dnepliuk/bluetooth-speaker-esp32/BluetoothSpeaker.kicad_pcb

## KiCad design BluetoothSpeaker.kicad_pcb (2026-11-05)

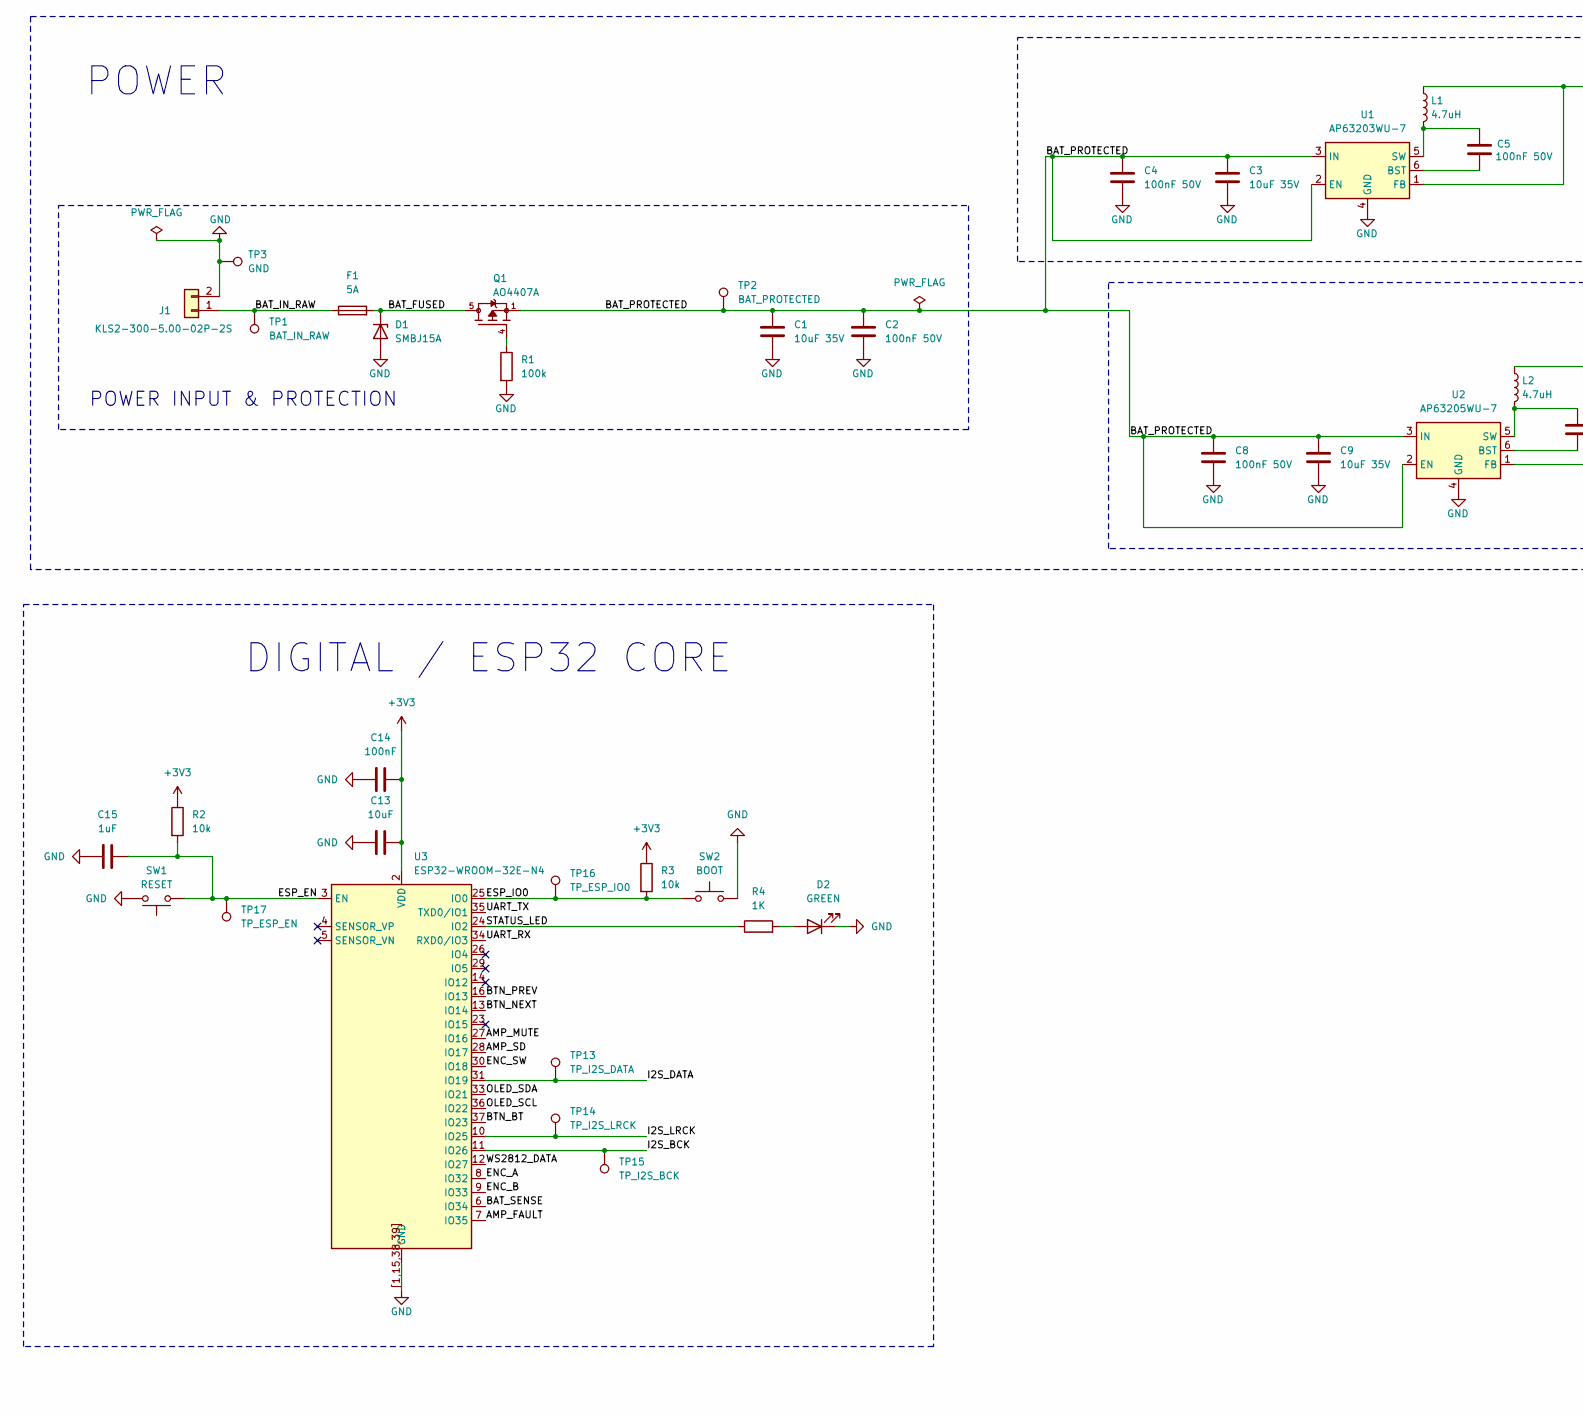
[picture p1: schematic BluetoothSpeaker.kicad_sch, part in row 1, column 1]

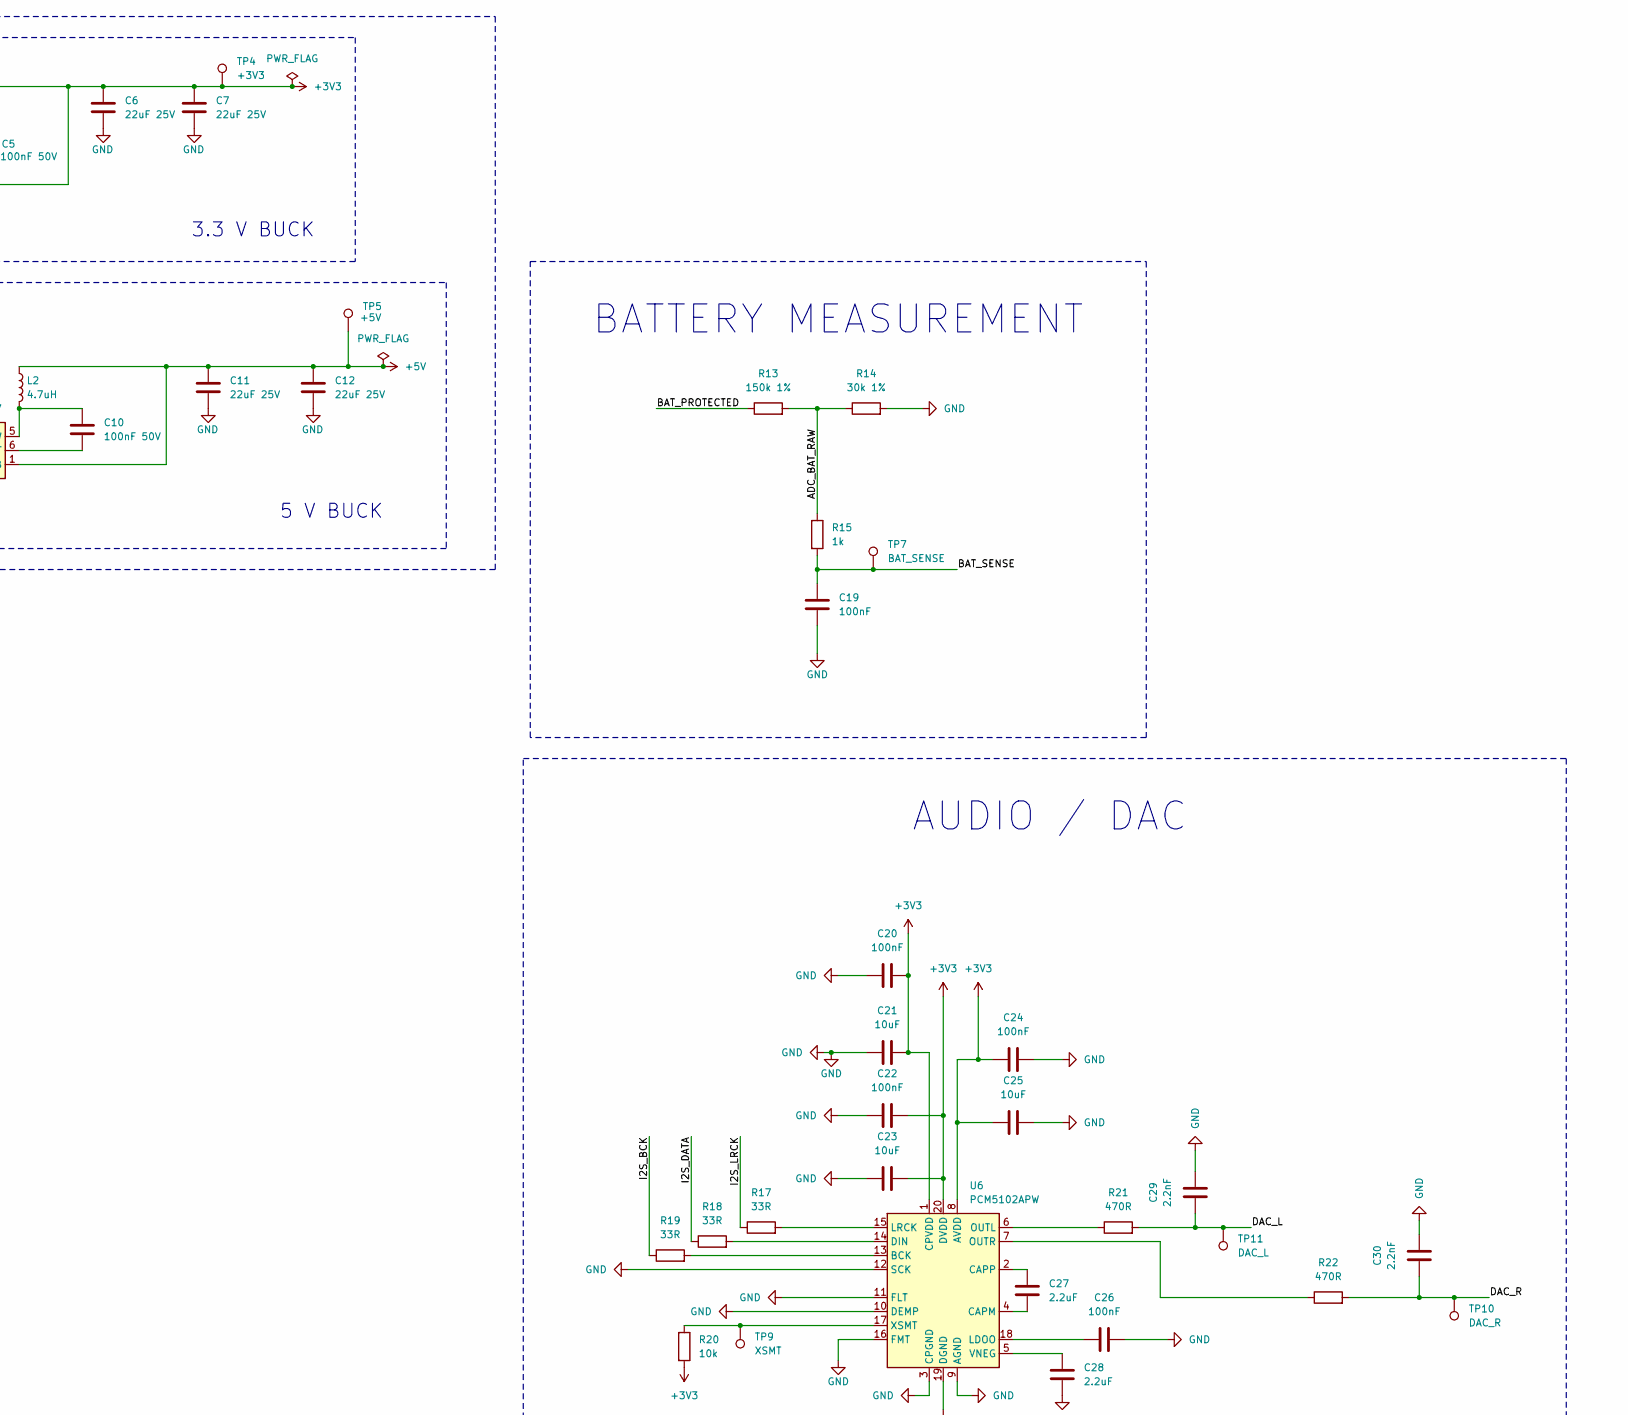
[picture p2: schematic BluetoothSpeaker.kicad_sch, part in row 1, column 2]

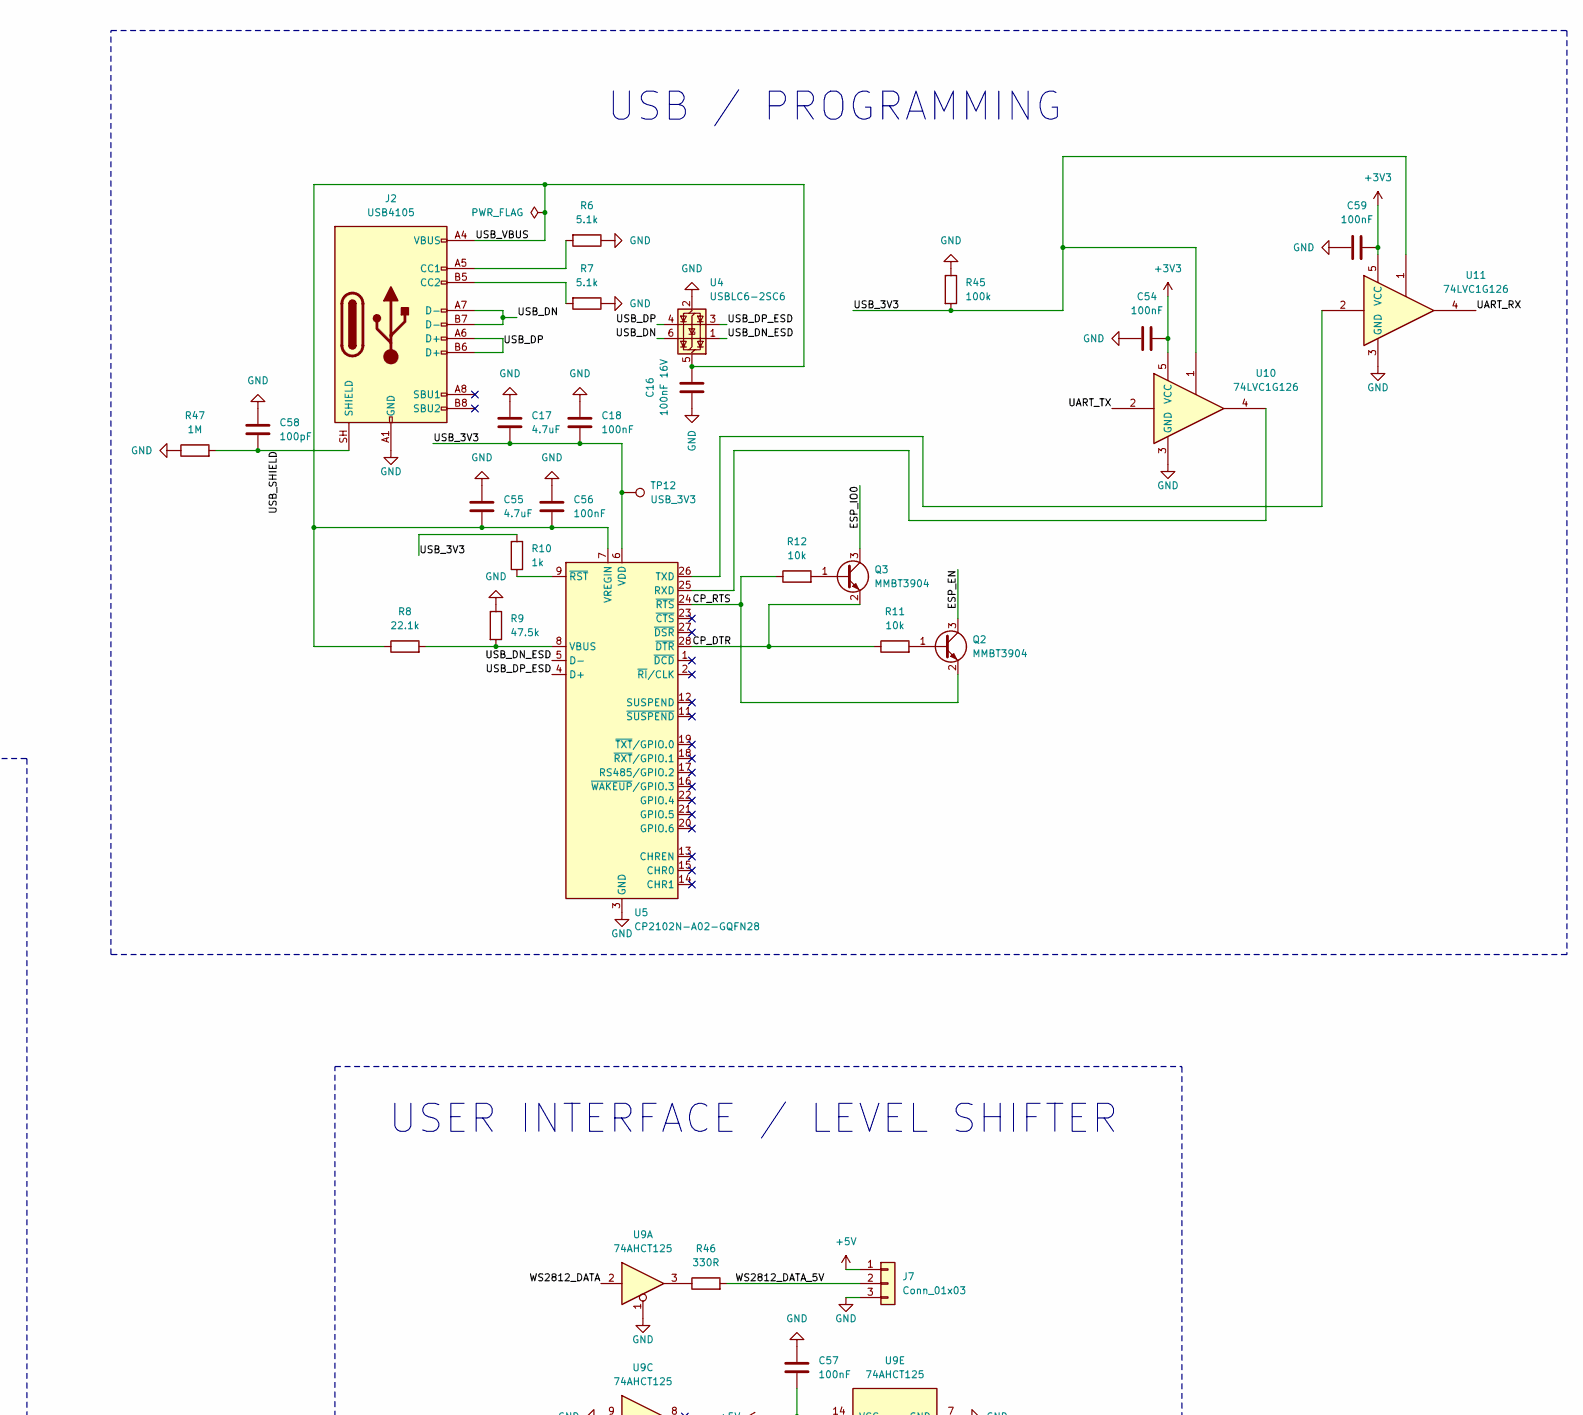
[picture p3: schematic BluetoothSpeaker.kicad_sch, part in row 1, column 3]

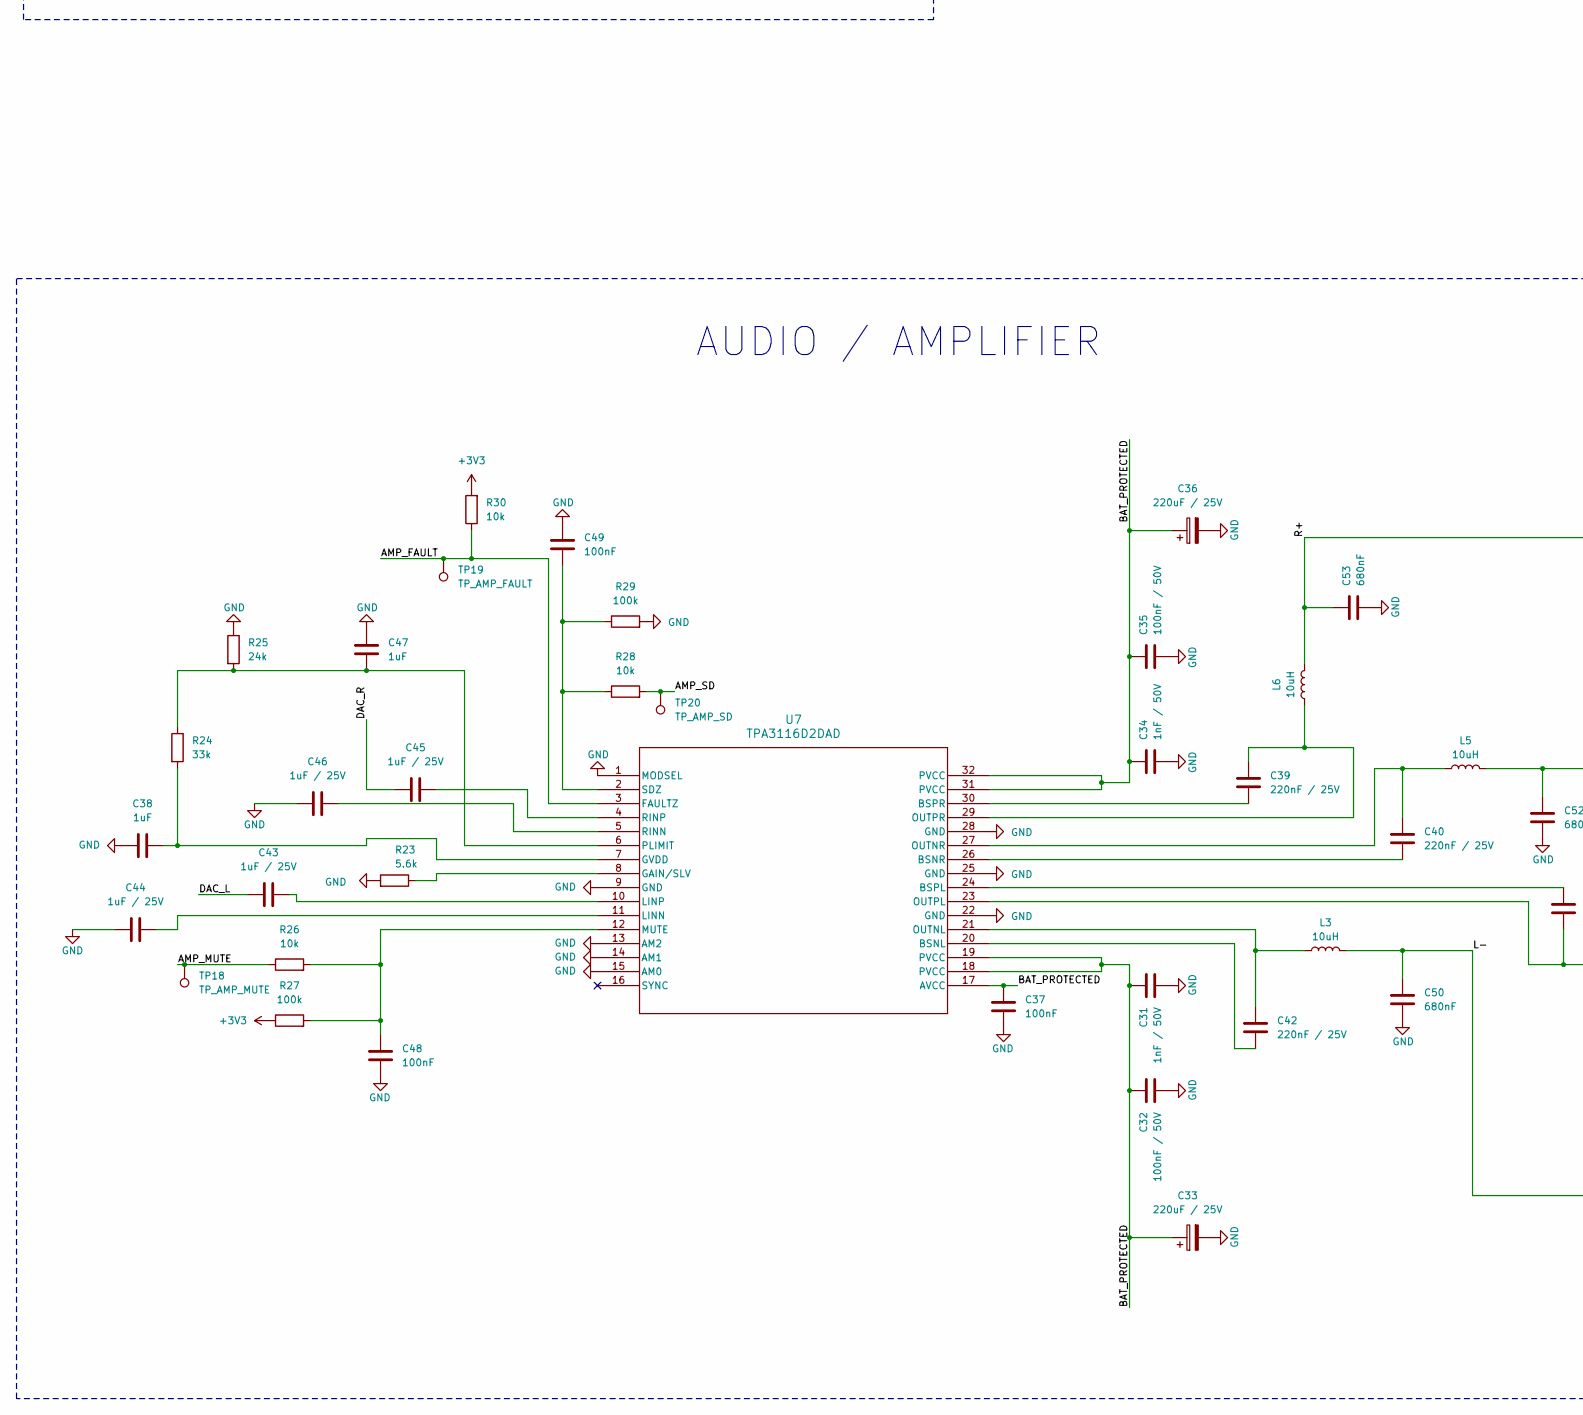
[picture p4: schematic BluetoothSpeaker.kicad_sch, part in row 2, column 1]

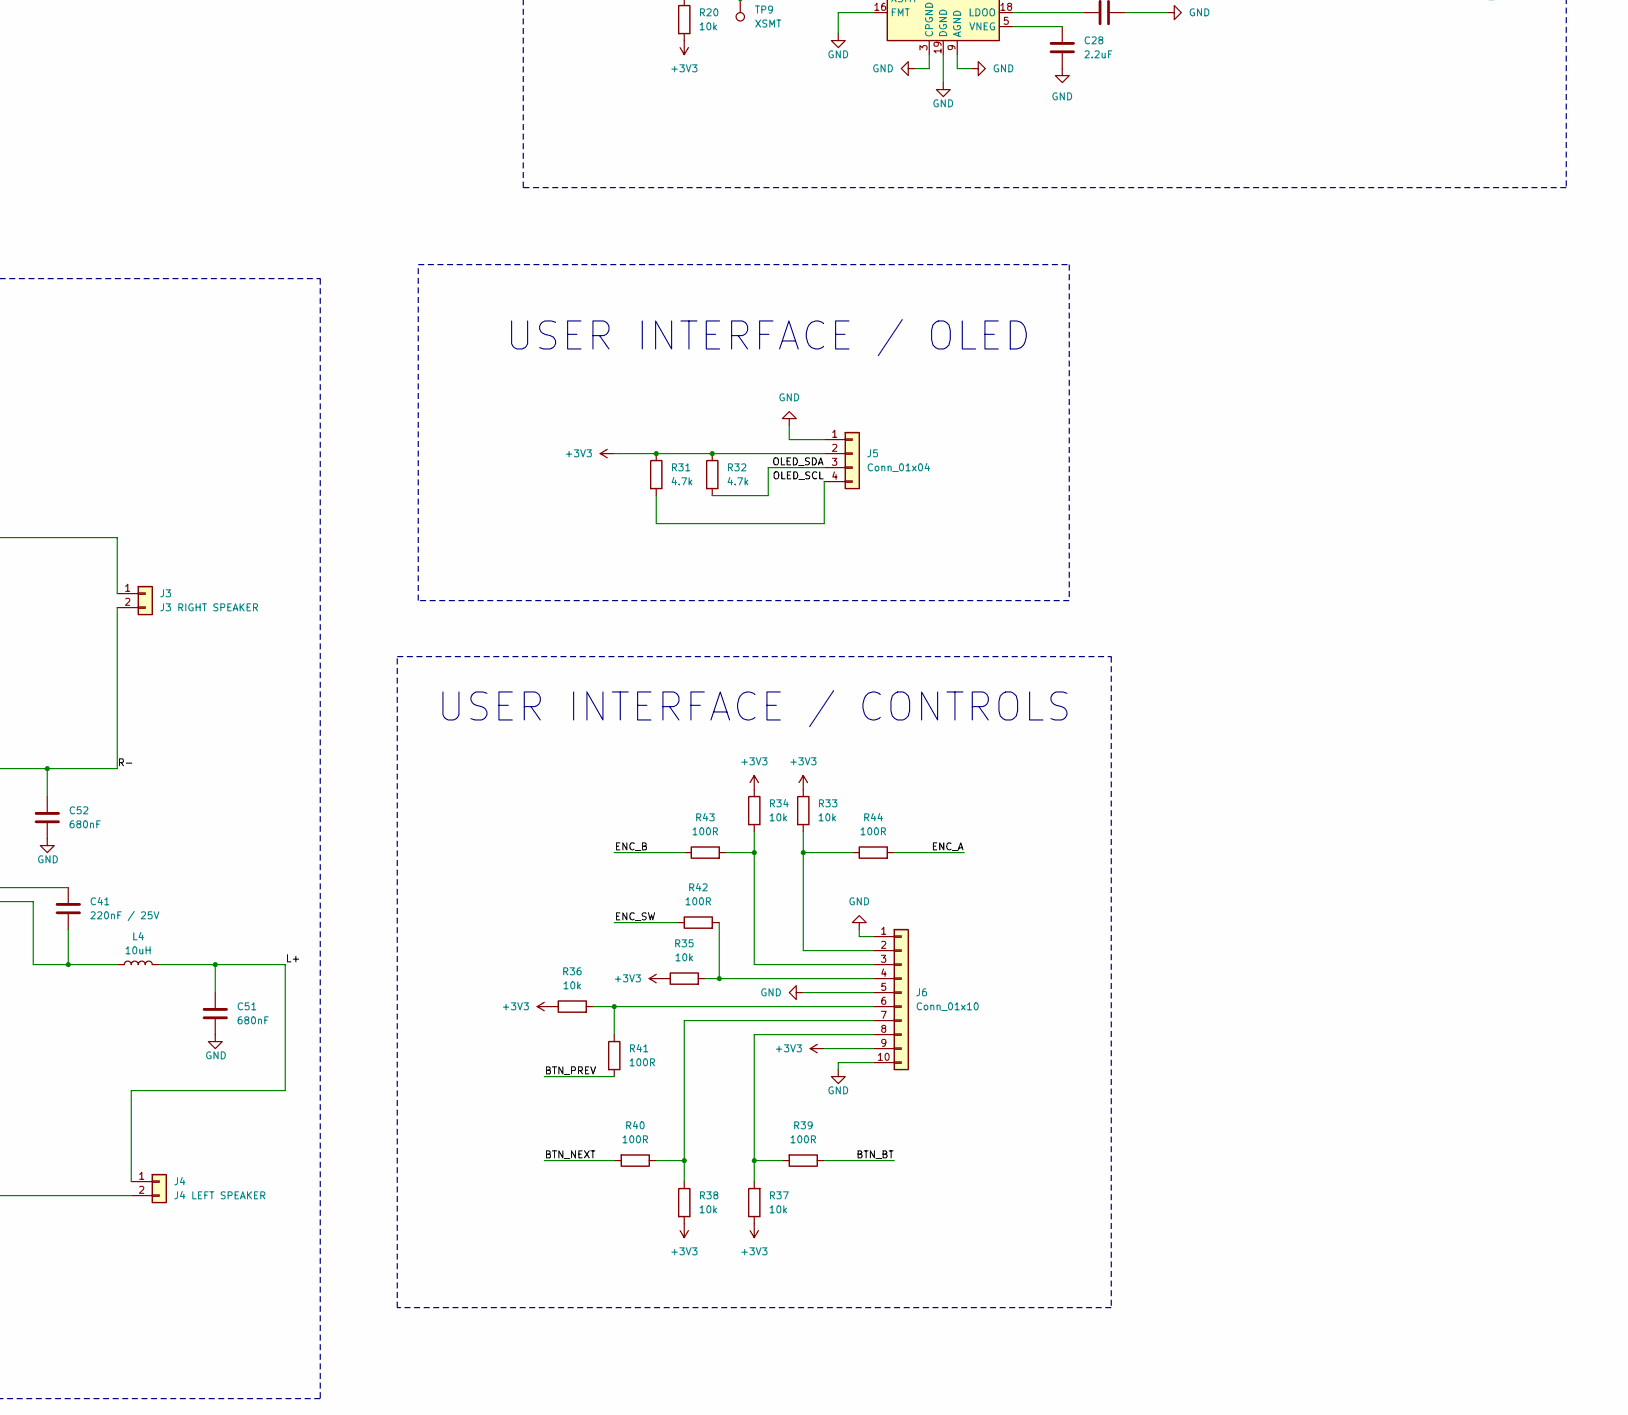
[picture p5: schematic BluetoothSpeaker.kicad_sch, part in row 2, column 2]

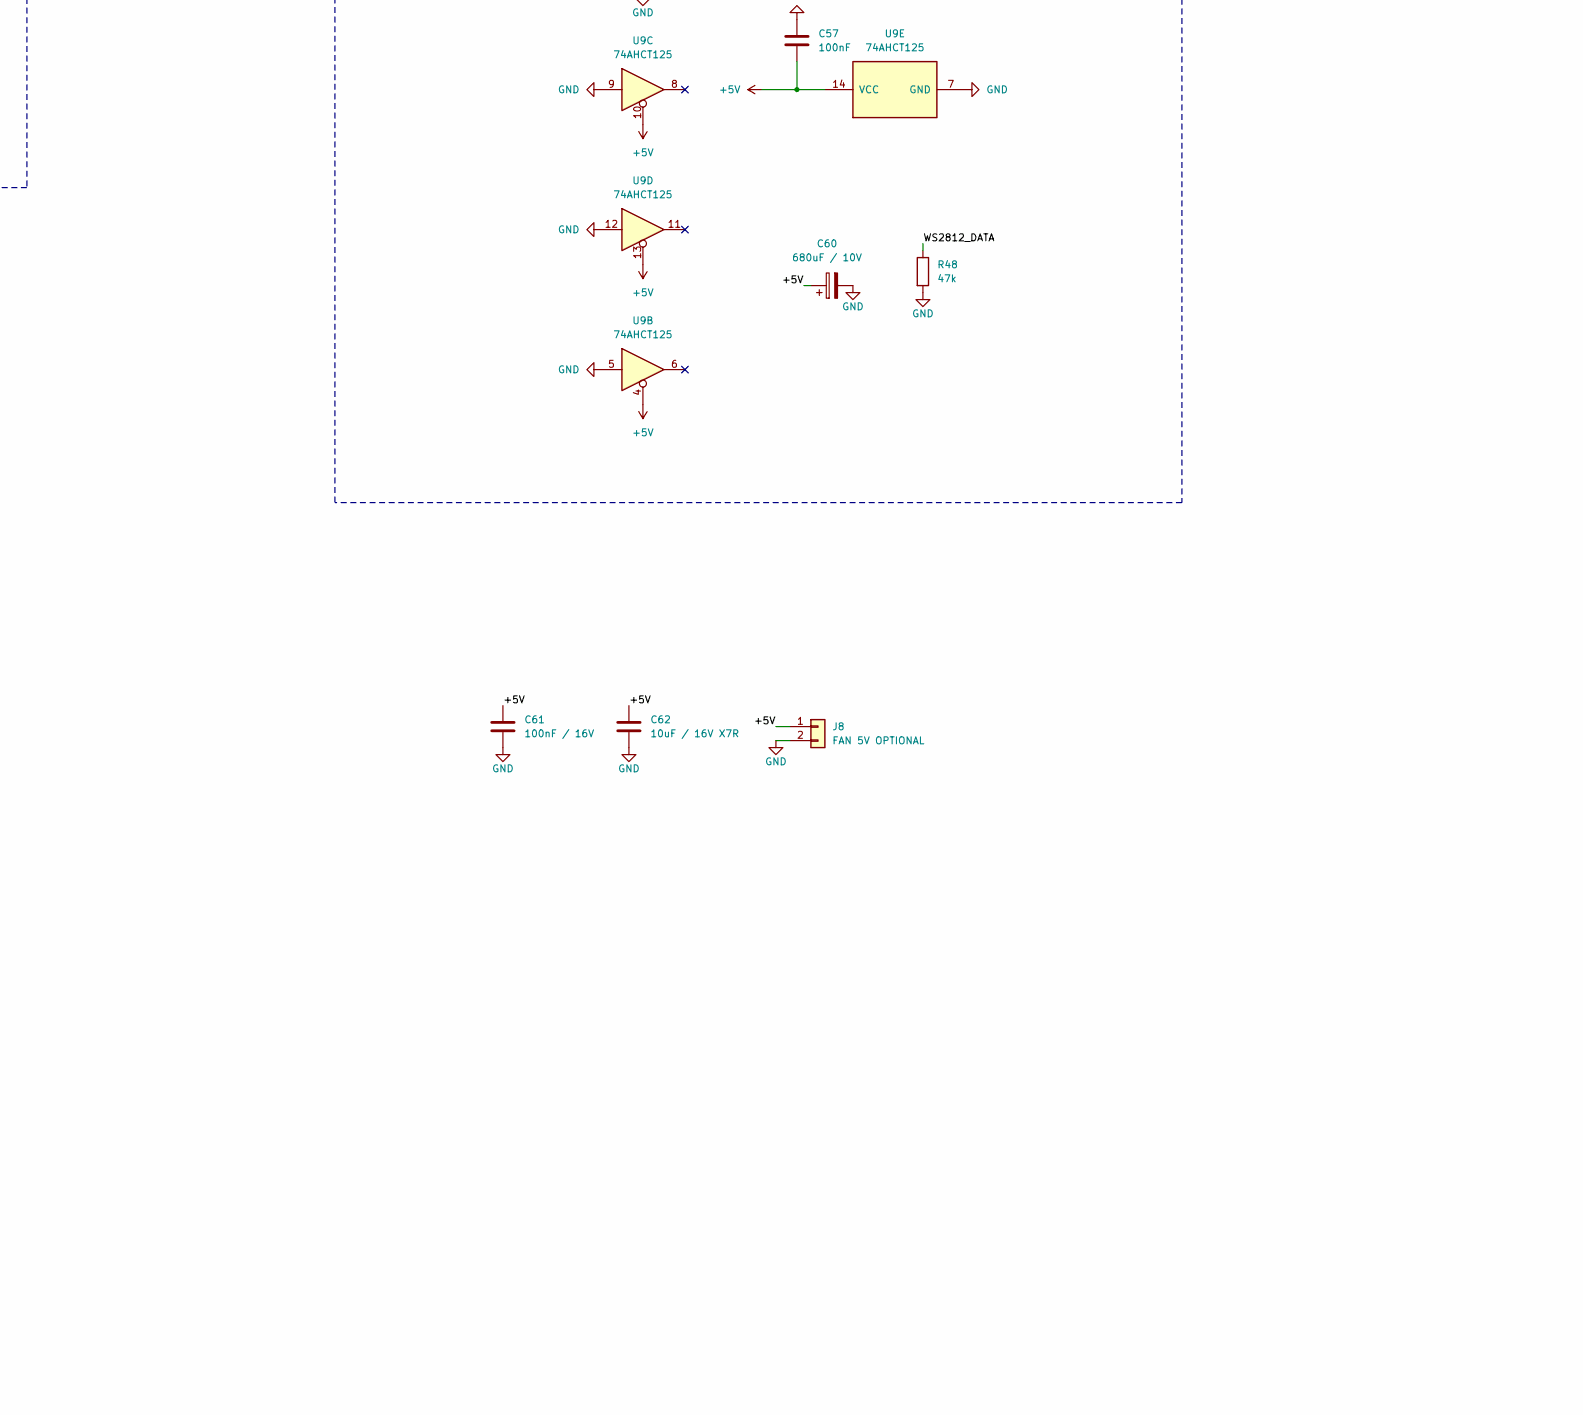
[picture p6: schematic BluetoothSpeaker.kicad_sch, part in row 2, column 3]

Parts:
C1, C3, C9: 10uF 35V; C_1210_3225Metric
C2, C4, C5, C8, C10: 100nF 50V; C_0805_2012Metric
C6, C7, C11, C12: 22uF 25V; C_1210_3225Metric
C13, C21, C23, C25: 10uF; C_1206_3216Metric
C14, C18, C19, C20, C22, C24, C26, C37, C48, C49, C54, C56, C57, C59: 100nF; C_0805_2012Metric
C15, C38, C47: 1uF; C_0805_2012Metric
C16: 100nF 16V; C_0805_2012Metric
C17, C55: 4.7uF; C_0805_2012Metric
C27, C28: 2.2uF; C_0805_2012Metric
C29, C30: 2.2nF; C_0805_2012Metric
C31, C34: 1nF / 50V; C_0805_2012Metric
C32, C35: 100nF / 50V; C_0805_2012Metric
C33, C36: 220uF / 25V; CP_Radial_D8.0mm_P3.50mm
C39, C40, C41, C42: 220nF / 25V; C_0805_2012Metric
C43, C44, C45, C46: 1uF / 25V; C_0805_2012Metric
C50, C51, C52, C53: 680nF; C_1812_4532Metric
C58: 100pF; C_1206_3216Metric
C60: 680uF / 10V; CP_Radial_D8.0mm_P3.50mm
C61: 100nF / 16V; C_0805_2012Metric
C62: 10uF / 16V X7R; C_1206_3216Metric
D1: SMBJ15A; D_SMB
D2: GREEN; LED_0805_2012Metric
F1: 5A; C_1808_4520Metric
J1: KLS2-300-5.00-02P-2S; TerminalBlock_MaiXu_MX126-5.0-02P_1x02_P5.00mm
J2: USB4105; GCT_USB4105_JLC
J3: J3 RIGHT SPEAKER; TerminalBlock_MaiXu_MX126-5.0-02P_1x02_P5.00mm
J4: J4 LEFT SPEAKER; TerminalBlock_MaiXu_MX126-5.0-02P_1x02_P5.00mm
J5: Conn_01x04; PinHeader_1x04_P2.54mm_Vertical
J6: Conn_01x10; PinHeader_1x10_P2.54mm_Vertical
J7: Conn_01x03; PinHeader_1x03_P2.54mm_Vertical
J8: FAN 5V OPTIONAL; PinHeader_1x02_P2.54mm_Vertical
L1, L2: 4.7uH; L_Bourns_SRR1260
L3, L4, L5, L6: 10uH; L_Bourns_SRR1260
Q1: AO4407A; SOIC127P600X175-8N; PARTREV I
Q2, Q3: MMBT3904; SOT-23
R1, R27, R29, R45: 100k; R_0805_2012Metric
R2, R3, R11, R12, R20, R26, R28, R30, R33, R34, R35, R36, R37, R38: 10k; R_0805_2012Metric
R4: 1K; R_0805_2012Metric
R6, R7: 5.1k; R_0805_2012Metric
R8: 22.1k; R_0805_2012Metric
R9: 47.5k; R_0805_2012Metric
R10, R15: 1k; R_0805_2012Metric
R13: 150k 1%; R_0805_2012Metric
R14: 30k 1%; R_0805_2012Metric
R17, R18, R19: 33R; R_0805_2012Metric
R21, R22: 470R; R_0805_2012Metric
R23: 5.6k; R_0805_2012Metric
R24: 33k; R_0805_2012Metric
R25: 24k; R_0805_2012Metric
R31, R32: 4.7k; R_0805_2012Metric
R39, R40, R41, R42, R43, R44: 100R; R_0805_2012Metric
R46: 330R; R_0805_2012Metric
R47: 1M; R_0805_2012Metric
R48: 47k; R_0805_2012Metric
SW1: RESET; SW_PUSH_6mm
SW2: BOOT; SW_PUSH_6mm
TP1: BAT_IN_RAW; TestPoint_THTPad_D2.0mm_Drill1.0mm
TP2: BAT_PROTECTED; TestPoint_THTPad_D2.0mm_Drill1.0mm
TP3: GND; TestPoint_THTPad_D2.0mm_Drill1.0mm
TP4: +3V3; TestPoint_THTPad_D2.0mm_Drill1.0mm
TP5: +5V; TestPoint_THTPad_D2.0mm_Drill1.0mm
TP7: BAT_SENSE; TestPoint_THTPad_D2.0mm_Drill1.0mm
TP9: XSMT; TestPoint_THTPad_D2.0mm_Drill1.0mm
TP10: DAC_R; TestPoint_THTPad_D2.0mm_Drill1.0mm
TP11: DAC_L; TestPoint_THTPad_D2.0mm_Drill1.0mm
TP12: USB_3V3; TestPoint_THTPad_D2.0mm_Drill1.0mm
TP13: TP_I2S_DATA; TestPoint_THTPad_D2.0mm_Drill1.0mm
TP14: TP_I2S_LRCK; TestPoint_THTPad_D2.0mm_Drill1.0mm
TP15: TP_I2S_BCK; TestPoint_THTPad_D2.0mm_Drill1.0mm
TP16: TP_ESP_IO0; TestPoint_THTPad_D2.0mm_Drill1.0mm
TP17: TP_ESP_EN; TestPoint_THTPad_D2.0mm_Drill1.0mm
TP18: TP_AMP_MUTE; TestPoint_THTPad_D2.0mm_Drill1.0mm
TP19: TP_AMP_FAULT; TestPoint_THTPad_D2.0mm_Drill1.0mm
TP20: TP_AMP_SD; TestPoint_THTPad_D2.0mm_Drill1.0mm
U1: AP63203WU-7; TSOT-23-6
U2: AP63205WU-7; TSOT-23-6
U3: ESP32-WROOM-32E-N4; ESP32-WROOM-32E_Drill030
U4: USBLC6-2SC6; SOT-23-6
U5: CP2102N-A02-GQFN28; CP2102N_QFN28_EP
U6: PCM5102APW; TSSOP-20_4.4x6.5mm_P0.65mm
U7: TPA3116D2DAD; Texas_DAD0032A_HTSSOP-32_6.1x11mm_P0.65mm_TopEP3.71x3.81mm
U9: 74AHCT125; SOIC-14_3.9x8.7mm_P1.27mm
U10, U11: 74LVC1G126; SOT-353_SC-70-5

Connections:
+3V3: C6.1, C7.1, C13.2, C14.2, C20.2, C21.2, C22.2, C23.2, C24.1, C25.1, C54.1, C59.1, J5.2, J6.9, L1.1, R2.1, R3.1, R20.2, R27.1, R30.2, R31.1, R32.1, R33.1, R34.1, R35.1, R36.1, R37.1, R38.2, TP4.1 (1_1), U1.1 (FB), U3.2 (VDD), U6.1 (CPVDD), U6.8 (AVDD), U6.20 (DVDD), U10.5 (VCC), U11.5 (VCC)
+5V: C11.1, C12.1, C57.2, C60.1, C61.1, C62.1, J7.1, J8.1, L2.1, TP5.1 (1_1), U2.1 (FB), U9.4, U9.10, U9.13, U9.14 (VCC)
/ADC_BAT_RAW: R13.2, R14.1, R15.1
/AMP_FAULT: R30.1, TP19.1 (1_1), U3.7 (IO35), U7.3 (FAULTZ)
/AMP_MUTE: R26.1, TP18.1 (1_1), U3.27 (IO16)
/AMP_SD: R28.2, TP20.1 (1_1), U3.28 (IO17)
/BAT_FUSED: D1.1 (K), F1.2, Q1.5, Q1.6, Q1.7, Q1.8
/BAT_IN_RAW: F1.1, J1.1, TP1.1 (1_1)
/BAT_PROTECTED: C1.1, C2.1, C3.1, C4.2, C8.1, C9.1, C31.1, C32.1, C33.1, C34.1, C35.1, C36.1, C37.1, Q1.1, Q1.2, Q1.3, R13.1, TP2.1 (1_1), U1.2 (EN), U1.3 (IN), U2.2 (EN), U2.3 (IN), U7.17 (AVCC), U7.18 (PVCC), U7.19 (PVCC), U7.31 (PVCC), U7.32 (PVCC)
/BAT_SENSE: C19.1, R15.2, TP7.1 (1_1), U3.6 (IO34)
/BTN_BT: R39.1, U3.37 (IO23)
/BTN_NEXT: R40.2, U3.13 (IO14)
/BTN_PREV: R41.2, U3.16 (IO13)
/CP_DTR: Q3.2 (E), R11.1, U5.28 (~DTR)
/CP_RTS: Q2.2 (E), R12.1, U5.24 (~RTS)
/DAC_L: C29.2, C43.1, R21.2, TP11.1 (1_1)
/DAC_R: C30.1, C45.1, R22.2, TP10.1 (1_1)
/ENC_A: R44.2, U3.8 (IO32)
/ENC_B: R43.1, U3.9 (IO33)
/ENC_SW: R42.1, U3.30 (IO18)
/ESP_EN: C15.1, Q2.3 (C), R2.2, SW1.1, TP17.1 (1_1), U3.3 (EN)
/ESP_IO0: Q3.3 (C), R3.2, SW2.1, TP16.1 (1_1), U3.25 (IO0)
/I2S_BCK: R19.1, TP15.1 (1_1), U3.11 (IO26)
/I2S_DATA: R18.1, TP13.1 (1_1), U3.31 (IO19)
/I2S_LRCK: R17.1, TP14.1 (1_1), U3.10 (IO25)
/L+: C51.1, J4.1, L4.2
/L-: C50.1, J4.2, L3.2
/OLED_SCL: J5.4, R31.2, U3.36 (IO22)
/OLED_SDA: J5.3, R32.2, U3.33 (IO21)
/R+: C53.1, J3.1, L6.2
/R-: C52.1, J3.2, L5.2
/STATUS_LED: R4.1, U3.24 (IO2)
/UART_RX: U3.34 (RXD0/IO3), U11.4
/UART_TX: U3.35 (TXD0/IO1), U10.2
/USB_3V3: C17.2, C18.2, R10.2, R45.2, TP12.1 (1_1), U5.6 (VDD), U10.1, U11.1
/USB_DN: J2.A7 (D-), J2.B7 (D-), U4.6 (I/O1)
/USB_DN_ESD: U4.1 (I/O1), U5.5 (D-)
/USB_DP: J2.A6 (D+), J2.B6 (D+), U4.4 (I/O2)
/USB_DP_ESD: U4.3 (I/O2), U5.4 (D+)
/USB_SHIELD: C58.2, J2.SH (SHIELD), R47.2
/USB_VBUS: C16.1, C55.2, C56.2, J2.A4 (VBUS), J2.A9 (VBUS), J2.B4 (VBUS), J2.B9 (VBUS), R8.1, U4.5 (VBUS), U5.7 (VREGIN)
/WS2812_DATA: R48.1, U3.12 (IO27), U9.2
/WS2812_DATA_5V: J7.2, R46.2
GND: C1.2, C2.2, C3.2, C4.1, C6.2, C7.2, C8.2, C9.2, C11.2, C12.2, C13.1, C14.1, C15.2, C16.2, C17.1, C18.1, C19.2, C20.1, C21.1, C22.1, C23.1, C24.2, C25.2, C26.2, C28.2, C29.1, C30.2, C31.2, C32.2, C33.2, C34.2, C35.2, C36.2, C37.2, C38.1, C44.1, C46.1, C47.1, C48.2, C49.1, C50.2, C51.2, C52.2, C53.2, C54.2, C55.1, C56.1, C57.1, C58.1, C59.2, C60.2, C61.2, C62.2, D1.2 (A), D2.1 (K), J1.2, J2.A1 (GND), J2.A12 (GND), J2.B1 (GND), J2.B12 (GND), J5.1, J6.1, J6.5, J6.10, J7.3, J8.2, R1.2, R6.1, R7.1, R9.1, R14.2, R23.2, R25.1, R29.2, R45.1, R47.1, R48.2, SW1.2, SW2.2, TP3.1 (1_1), U1.4 (GND), U2.4 (GND), U3.1 (GND), U3.15 (GND), U3.38 (GND), U3.39 (GND), U3.[1,15,38,39] (GND), U4.2 (GND), U5.3 (GND), U5.29 (GND), U6.3 (CPGND), U6.9 (AGND), U6.10 (DEMP), U6.11 (FLT), U6.12 (SCK), U6.16 (FMT), U6.19 (DGND), U7.1 (MODSEL), U7.9 (GND), U7.13 (AM2), U7.14 (AM1), U7.15 (AM0), U7.22 (GND), U7.25 (GND), U7.28 (GND), U9.1, U9.5, U9.7 (GND), U9.9, U9.12, U10.3 (GND), U11.3 (GND)
unnamed: D2.2 (A), R4.2
unnamed: J2.A5 (CC1), R6.2
unnamed: J2.B5 (CC2), R7.2
unnamed: J6.2, R33.2, R44.1
unnamed: J6.3, R34.2, R43.2
unnamed: J6.4, R35.2, R42.2
unnamed: J6.6, R36.2, R41.1
unnamed: J6.7, R38.1, R40.1
unnamed: J6.8, R37.2, R39.2
unnamed: Q1.4, R1.1
unnamed: Q2.1 (B), R11.2
unnamed: Q3.1 (B), R12.2
unnamed: R46.1, U9.3
unnamed: C5.2, U1.6 (BST)
unnamed: C5.1, L1.2, U1.5 (SW)
unnamed: C10.2, U2.6 (BST)
unnamed: C10.1, L2.2, U2.5 (SW)
unnamed: U5.25 (RXD), U10.4
unnamed: U5.26 (TXD), U11.2
unnamed: R8.2, R9.2, U5.8 (VBUS)
unnamed: R10.1, U5.9 (~RST)
unnamed: R19.2, U6.13 (BCK)
unnamed: C27.2, U6.4 (CAPM)
unnamed: C27.1, U6.2 (CAPP)
unnamed: R18.2, U6.14 (DIN)
unnamed: C26.1, U6.18 (LDOO)
unnamed: R17.2, U6.15 (LRCK)
unnamed: R21.1, U6.6 (OUTL)
unnamed: R22.1, U6.7 (OUTR)
unnamed: C28.1, U6.5 (VNEG)
unnamed: R20.1, TP9.1 (1_1), U6.17 (XSMT)
unnamed: C42.2, U7.20 (BSNL)
unnamed: C40.2, U7.26 (BSNR)
unnamed: C41.1, U7.24 (BSPL)
unnamed: C39.2, U7.30 (BSPR)
unnamed: R23.1, U7.8 (GAIN/SLV)
unnamed: C38.2, R24.2, U7.7 (GVDD)
unnamed: C44.2, U7.11 (LINN)
unnamed: C43.2, U7.10 (LINP)
unnamed: C48.1, R26.2, R27.2, U7.12 (MUTE)
unnamed: C42.1, L3.1, U7.21 (OUTNL)
unnamed: C40.1, L5.1, U7.27 (OUTNR)
unnamed: C41.2, L4.1, U7.23 (OUTPL)
unnamed: C39.1, L6.1, U7.29 (OUTPR)
unnamed: C47.2, R24.1, R25.2, U7.6 (PLIMIT)
unnamed: C46.2, U7.5 (RINN)
unnamed: C45.2, U7.4 (RINP)
unnamed: C49.2, R28.1, R29.1, U7.2 (SDZ)

Notes on the sheet:
3.3 V BUCK
AUDIO / DAC
USB / PROGRAMMING
USER INTERFACE / OLED
USER INTERFACE / CONTROLS
5 V BUCK
USER INTERFACE / LEVEL SHIFTER
DIGITAL / ESP32 CORE
AUDIO / AMPLIFIER
BATTERY MEASUREMENT
POWER INPUT & PROTECTION
POWER

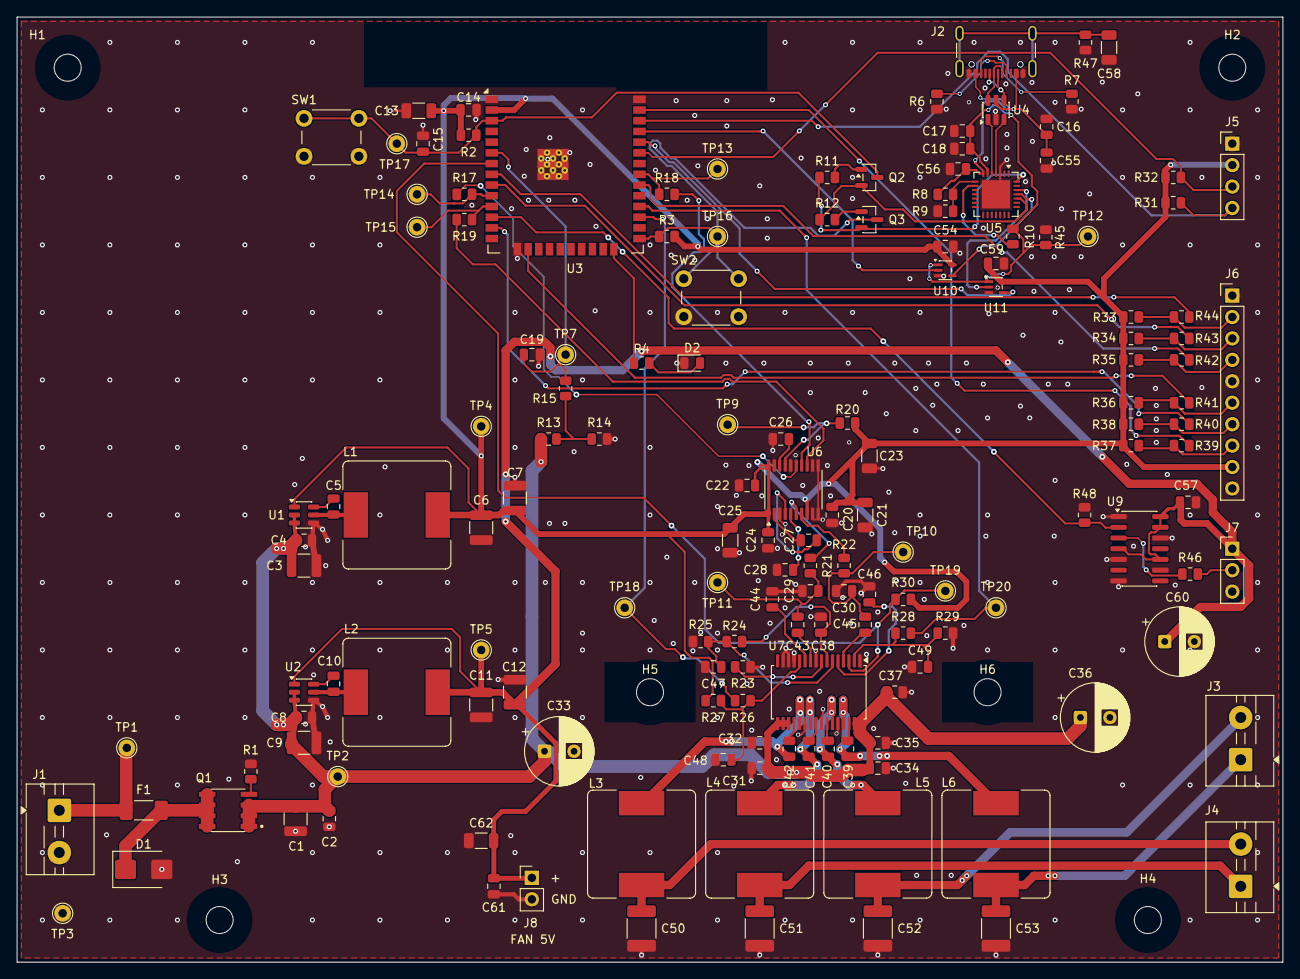
[picture p7: board BluetoothSpeaker.kicad_pcb from above]

Board: 2 copper layers, 150.0 x 112.0 mm, 164 parts (0 on the bottom side), 92 nets.

Other parts of the board:
H1, H2, H3, H4: MountingHole; MountingHole_3.2mm_M3
H5, H6: ATS #4-40 clearance 3.2mm; MountingHole_3.2mm_M3
