dnepliuk/bluetooth-speaker-esp32/(commit log)

2026-10-02 feat: add initial power and ESP32 core schematic
    [.kicad_sch, BluetoothSpeaker.kicad_sch]
2026-10-04 feat: update amplifier output stage and add OLED interface
    [BluetoothSpeaker.kicad_sch]
2026-10-05 feat: add user interface controls and finalize speaker outputs
    [BluetoothSpeaker.kicad_sch]
2026-10-06 Complete schematic ERC and WS2812 interface
    [BluetoothSpeaker.kicad_sch]
2026-10-11 feat: finalize schematic and initialize PCB layout
2026-11-03 Update PCB layout and remove unused project files
